mcrepeau/matrix_powerboard/powerboard/powerboard.png

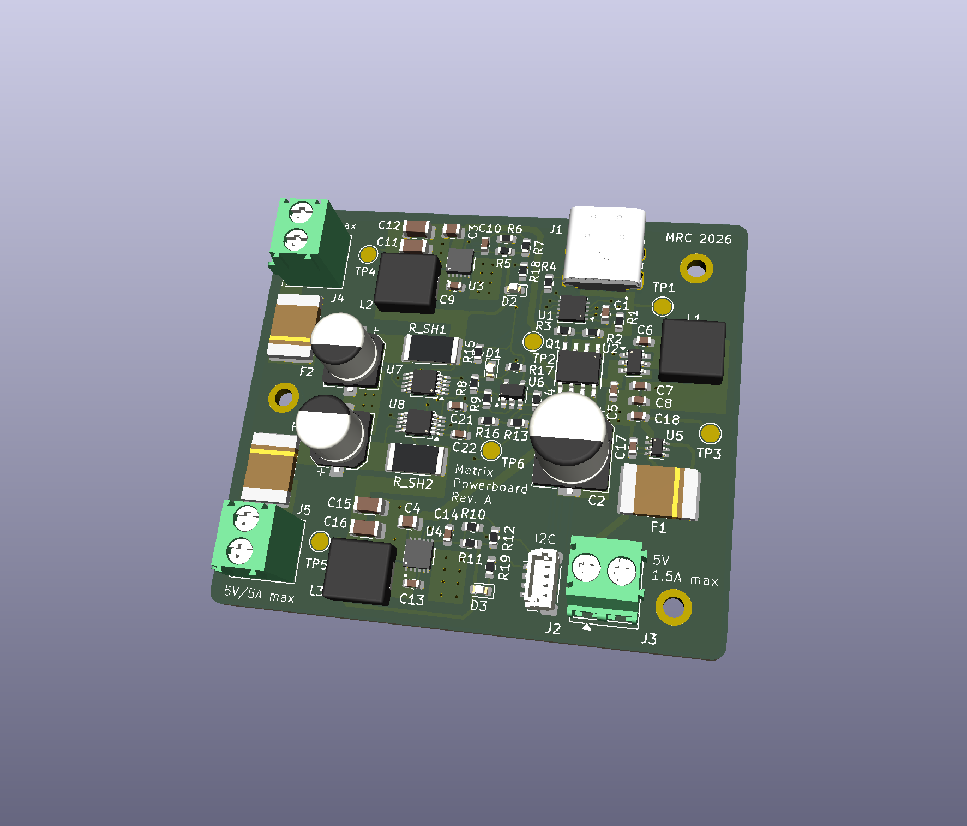
powerboard/powerboard.png
