mcrepeau/matrix_powerboard/hardware/powerboard.csv

Reference | Qty | Value | DNP | Footprint | Description | Part Number | LCSC Part #
C1,C17,C18 | 3 | 1µF/50V |  | Capacitor_SMD:C_0603_1608Metric | Unpolarized capacitor | CL10A105KB8NNNC | C15849
C2 | 1 | 100µF/35V |  | Capacitor_SMD:CP_Elec_8x10 | Polarized capacitor | GAM35V100M8X10 | C53446710
C3,C4,C5 | 3 | 10µF/50V |  | Capacitor_SMD:C_0805_2012Metric | Unpolarized capacitor | GRM21BR61H106KE43L | C440198
C6 | 1 | 100nF/50V |  | Capacitor_SMD:C_0603_1608Metric | Unpolarized capacitor | CC0603KRX7R9BB104 | C14663
C7,C8 | 2 | 22µF/25V |  | Capacitor_SMD:C_0805_2012Metric | Unpolarized capacitor | CL21A226MAQNNNE | C91604
C9,C13,C21,C22,C25 | 5 | 100nF |  | Capacitor_SMD:C_0603_1608Metric | Unpolarized capacitor | CC0603KRX7R9BB104 | C14663
C10,C14 | 2 | 33pF |  | Capacitor_SMD:C_0603_1608Metric | Unpolarized capacitor | CL10C330JB8NNNC | C1663
C11,C12,C15,C16 | 4 | 47µF/10V |  | Capacitor_SMD:C_1206_3216Metric | Unpolarized capacitor | CL31A476MPHNNNE | C96123
C19,C20 | 2 | 220µF/10V |  | Capacitor_SMD:CP_Elec_6.3x7.7 | Polarized capacitor | EEEFPA221XAP | C278407
D1 | 1 | RED LED |  | LED_SMD:LED_0805_2012Metric | Light emitting diode | NCD0805R1 | C84256
D2,D3 | 2 | GREEN LED |  | LED_SMD:LED_0805_2012Metric | Light emitting diode | KT-0805G | C2297
F1 | 1 | 1206L100/12NR |  | Fuse:Fuse_1206_3216Metric | Resettable fuse, polymeric positive temperature coefficient | 1206L100/12NR | C55089856
F2,F3 | 2 | 2920L700/12MR |  | Fuse:Fuse_2920_7451Metric | Resettable fuse, polymeric positive temperature coefficient | 2920L700/12MR | C207092
J1 | 1 | USB4085-GF-A |  | USB4085-GF-A_REVA4:GCT_USB4085-GF-A_REVA4 | USB-C (USB TYPE-C) USB 2.0 Receptacle Connector 24 (16+8 Dummy) Position Through Hole, Right Angle, low cost, 3.46mm profile, 16 pin, horizontal, Top mount | USB4085-GF-A | C7095263
J2 | 1 | SH1.0mm-4P-LT |  | Connector_JST:JST_SH_BM04B-SRSS-TB_1x04-1MP_P1.00mm_Vertical | Generic connector, single row, 01x04, script generated (kicad-library-utils/schlib/autogen/connector/) | BM04B-SRSS-TB | C160390
L1,L2,L3 | 3 | 4.7µH |  | Inductor_SMD:L_Bourns_SRP7028A_7.3x6.6mm | Inductor | APS0650M4R7A | C47327217
Q1 | 1 | AOSP21357 |  | AOSP21357:SO8SOP-8L_AOS-L |  | AOSP21357 | C541725
R1 | 1 | 10 |  | Resistor_SMD:R_0603_1608Metric | Resistor | 0603WAF100JT5E | C22859
R2 | 1 | 49.9K |  | Resistor_SMD:R_0603_1608Metric | Resistor | 0603WAF4992T5E | C23184
R3 | 1 | 5.1K |  | Resistor_SMD:R_0603_1608Metric | Resistor | 0603WAF5101T5E | C23186
R4 | 1 | 22.6k 1% |  | Resistor_SMD:R_0603_1608Metric | Resistor | CR0603FA2262G | C100874
R5,R11 | 2 | 100k 1% |  | Resistor_SMD:R_0603_1608Metric | Resistor | 0603WAF1003T5E | C25803
R6,R10 | 2 | 19.1k 1% |  | Resistor_SMD:R_0603_1608Metric | Resistor | CR0603FA1912G | C100835
R7,R12,R15 | 3 | 1k |  | Resistor_SMD:R_0603_1608Metric | Resistor | 0603WAF1001T5E | C21190
R8 | 1 | 100k |  | Resistor_SMD:R_0603_1608Metric | Resistor | 0603WAF1003T5E | C25803
R9 | 1 | 13k |  | Resistor_SMD:R_0603_1608Metric | Resistor | 0603WAF1302T5E | C22797
R13 | 1 | 510k |  | Resistor_SMD:R_0603_1608Metric | Resistor | 0603WAF5103T5E | C23192
R14 | 1 | 39k |  | Resistor_SMD:R_0603_1608Metric | Resistor | 0603WAF3902T5E | C23153
R16 | 1 | 2M |  | Resistor_SMD:R_0603_1608Metric | Resistor | 0603WAF2004T5E | C22976
R17 | 1 | 10k |  | Resistor_SMD:R_0603_1608Metric | Resistor | 0603WAF1002T5E | C25804
R18,R19 | 2 | 2.2k |  | Resistor_SMD:R_0603_1608Metric | Resistor | 0603WAF2201T5E | C4190
R_SH1,R_SH2 | 2 | 2mΩ 1% ≥1W |  | Resistor_SMD:R_2512_6332Metric | Resistor | RLP25FEER002 | C160590
U1 | 1 | HUSB238_002 |  | Package_DFN_QFN:WDFN-10-1EP_3x3mm_P0.5mm_EP1.8x2.5mm | USB-PD Sink IC Port Controller, VBUS = 3..25V, USB Type-C rev. 1.4, USB-PD rev. 3.0, BC1.2, WDFN-10 / WSON-10 | HUSB238_002DD | C7471904
U2 | 1 | AP63205 |  | Package_TO_SOT_SMD:TSOT-23-6 | 2A, 1.1MHz Buck DC/DC Converter, fixed 5.0V output voltage, TSOT-23-6 | AP63205WU-7 | C2071056
U3,U4 | 2 | LMR51450 |  | LMR51450:WSON_SDRRR_TEX |  | LMR51450SDRRR | C6890985
U5 | 1 | LM66100 |  | Package_TO_SOT_SMD:SOT-363_SC-70-6 | Ideal Diode With Input Polarity Protection 1.5 - 5.5V Input Voltage, 1.5A Output Current, Ron 141 mOhm, SC-70-6 | LM66100DCK | C2832141
U6 | 1 | LM397 |  | Package_TO_SOT_SMD:SOT-23-5 | Single General-Purpose Voltage Comparator with Open-Collector Output, SOT-23-5 | LM397MFX/NOPB | C132076
U7,U8 | 2 | INA226 |  | Package_SO:TSSOP-10_3x3mm_P0.5mm | High-Side or Low-Side Measurement, Bi-Directional Current and Power Monitor (0-36V) with I2C Compatible Interface, TSSOP-10 (Texas DGS0010A / VSSOP) | INA226AIDGSR | C49851
