mcrepeau/matrix_powerboard/hardware/powerboard.pdf

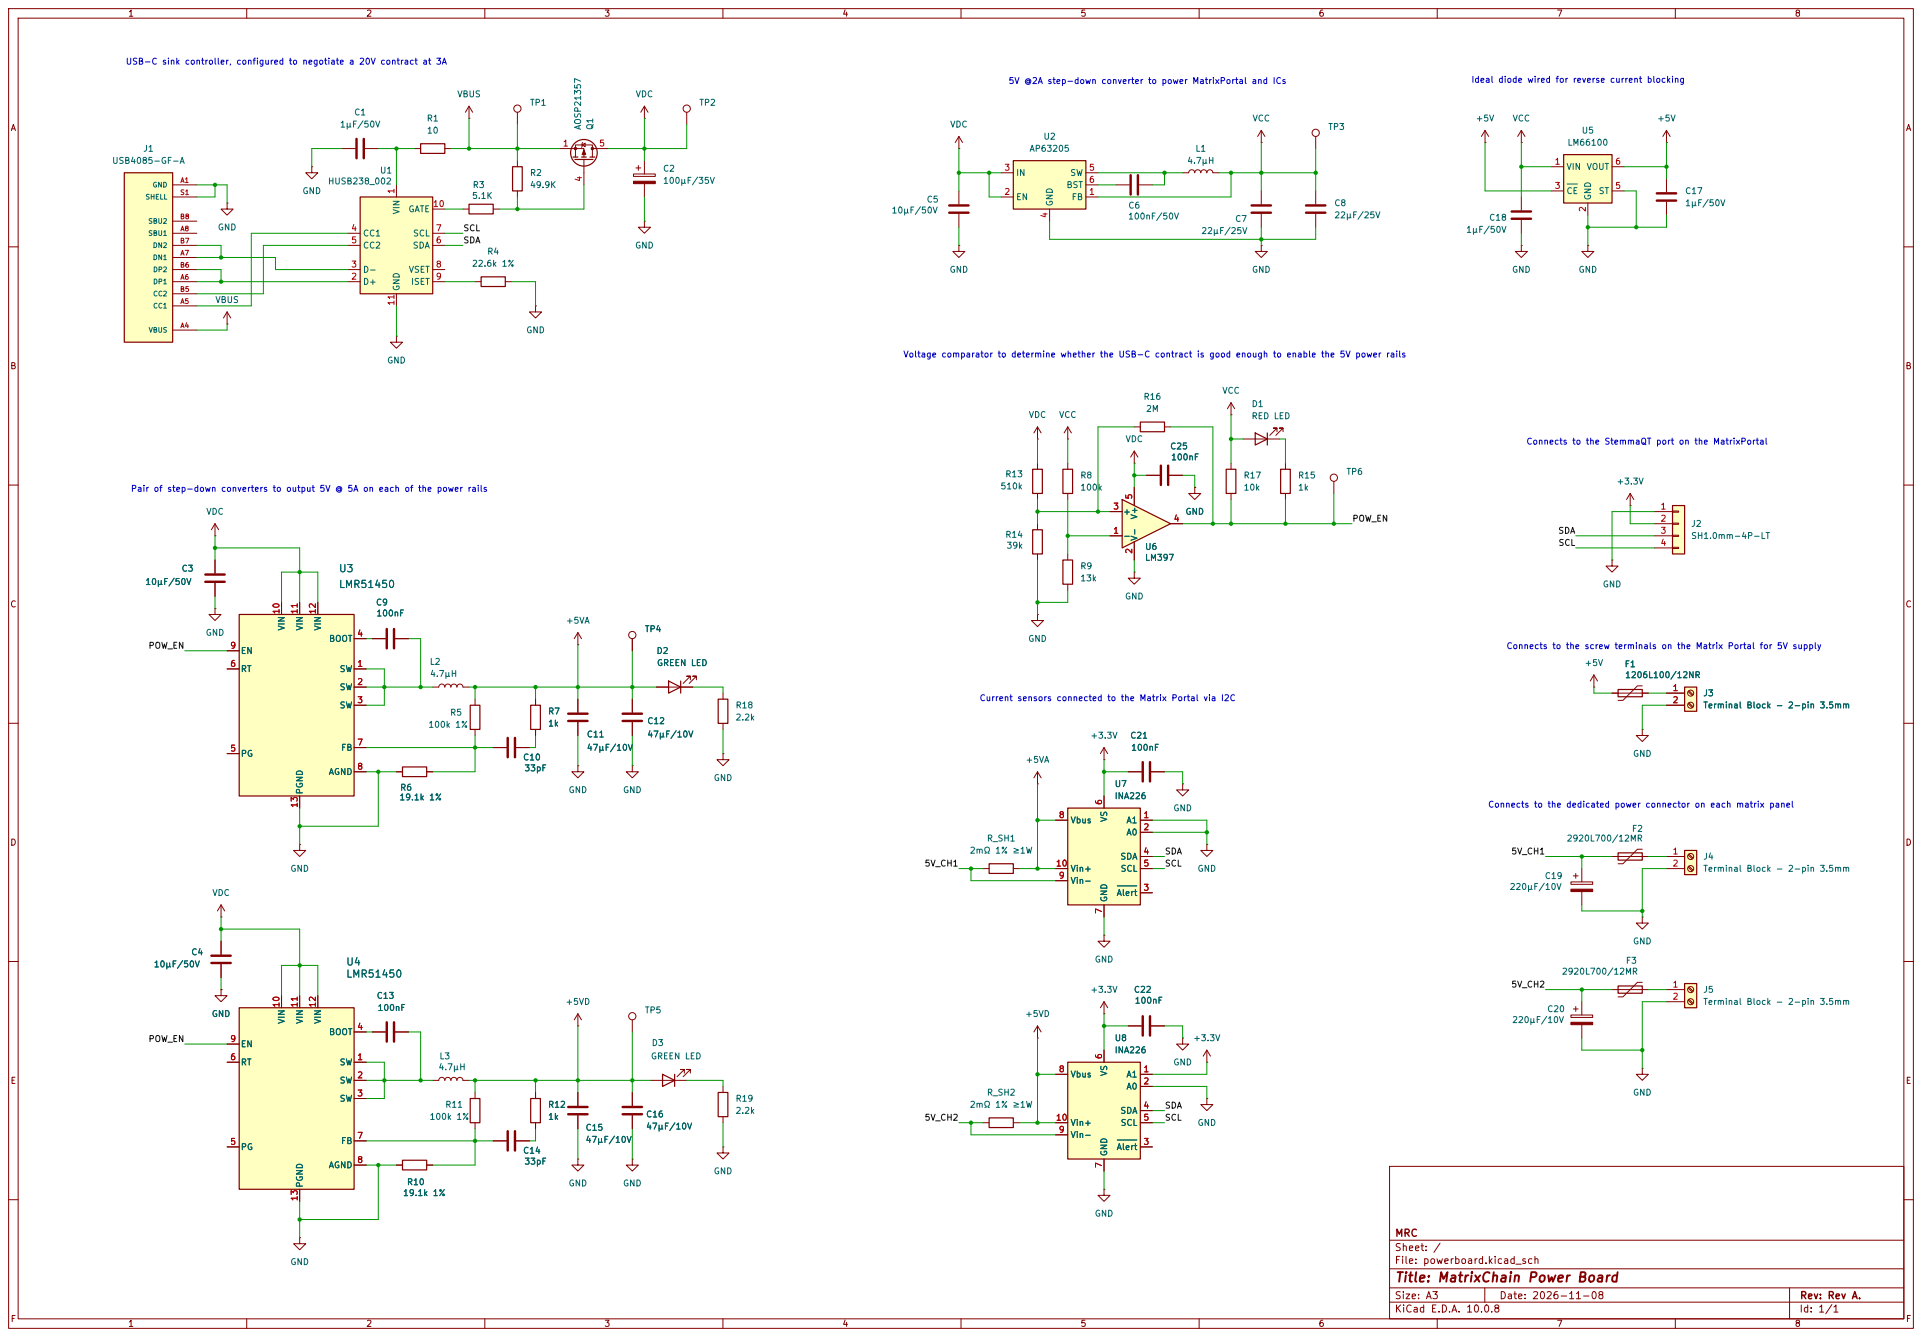
[picture p2: page 1]

Ideal diode wired for reverse current blocking

Connects to the dedicated power connector on each matrix panel Current sensors connected to the Matrix Portal via I2C

MRC
Sheet: /
File: powerboard.kicad_sch
Title: MatrixChain Power Board

Size: A3 | Rev: Rev A. | F Date: 2026-11-08
KiCad E.D.A. 10.0.8 | Id: 1/1
