mcrepeau/matrix_powerboard/hardware/powerboard.kicad_pcb

## KiCad design hardware/powerboard.kicad_pcb (2026-11-14)

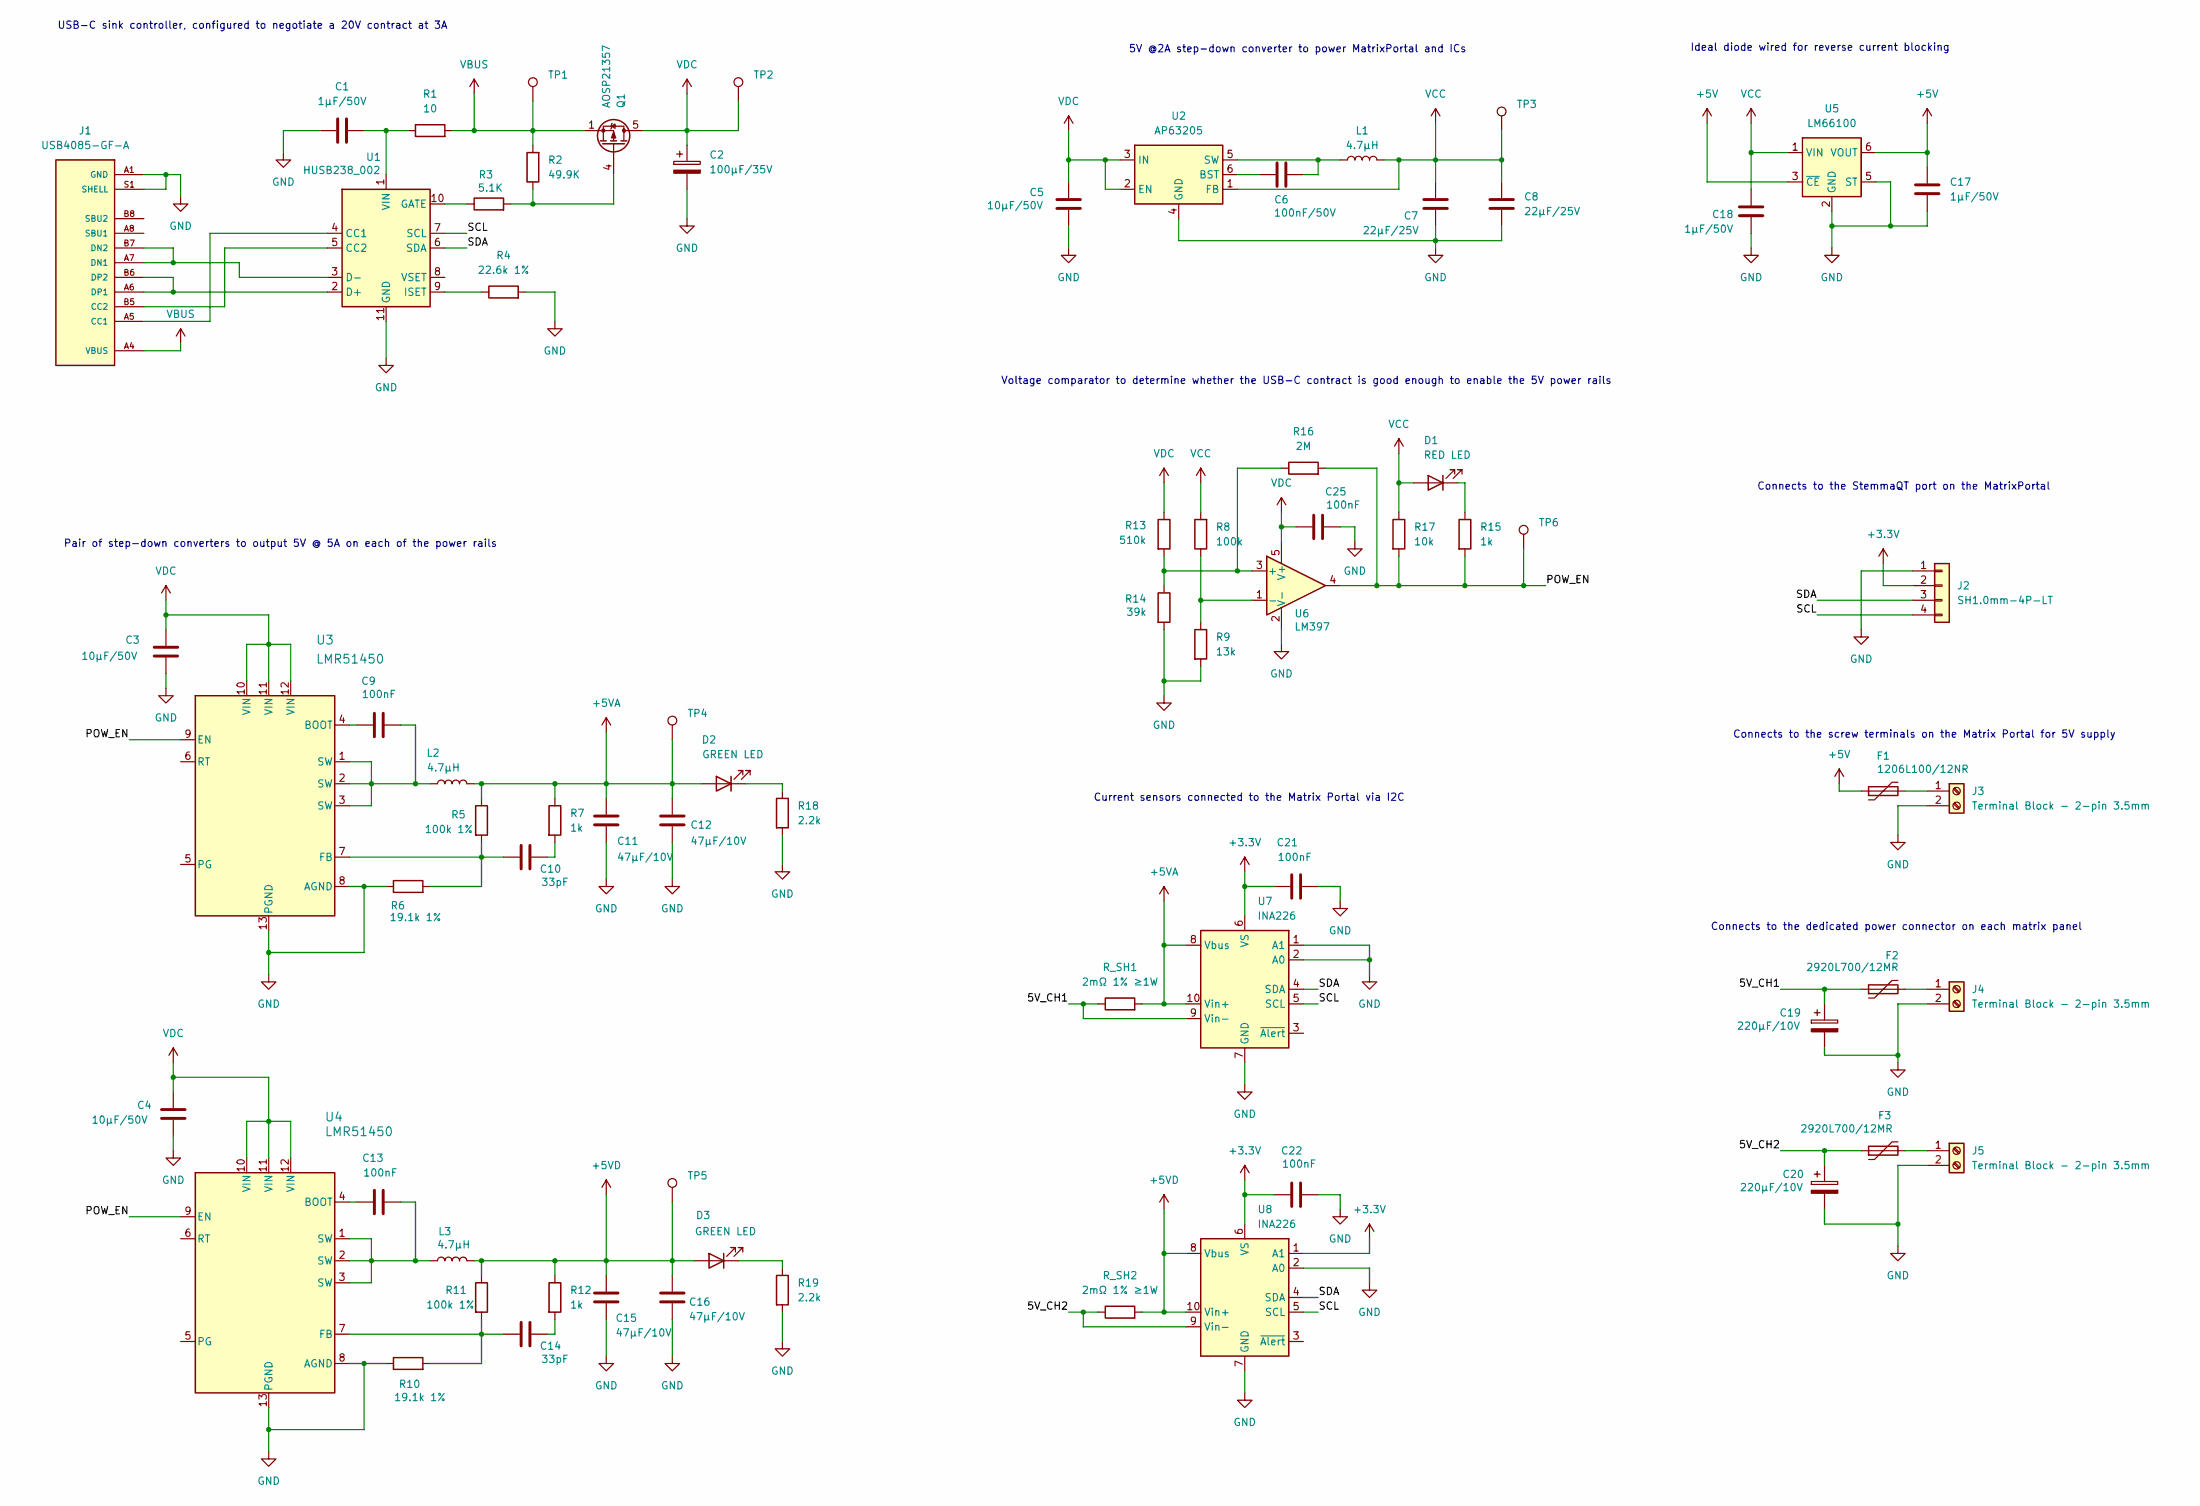
[picture p3: schematic powerboard.kicad_sch, MatrixChain Power Board]

Parts:
C1, C17, C18: 1µF/50V; C_0603_1608Metric; Part Number CL10A105KB8NNNC; LCSC Part # C15849
C2: 100µF/35V; CP_Elec_8x10; Part Number GAM35V100M8X10; LCSC Part # C53446710
C3, C4, C5: 10µF/50V; C_0805_2012Metric; Part Number GRM21BR61H106KE43L; LCSC Part # C440198
C6: 100nF/50V; C_0603_1608Metric; Part Number CC0603KRX7R9BB104; LCSC Part # C14663
C7, C8: 22µF/25V; C_0805_2012Metric; Part Number CL21A226MAQNNNE; LCSC Part # C91604
C9, C13, C21, C22, C25: 100nF; C_0603_1608Metric; Part Number CC0603KRX7R9BB104; LCSC Part # C14663
C10, C14: 33pF; C_0603_1608Metric; Part Number CL10C330JB8NNNC; LCSC Part # C1663
C11, C12, C15, C16: 47µF/10V; C_1206_3216Metric; Part Number CL31A476MPHNNNE; LCSC Part # C96123
C19, C20: 220µF/10V; CP_Elec_6.3x7.7; Part Number EEEFPA221XAP; LCSC Part # C278407
D1: RED LED; LED_0805_2012Metric; Part Number NCD0805R1; LCSC Part # C84256
D2, D3: GREEN LED; LED_0805_2012Metric; Part Number KT-0805G; LCSC Part # C2297
F1: 1206L100/12NR; Fuse_1206_3216Metric; Part Number 1206L100/12NR; LCSC Part # C55089856
F2, F3: 2920L700/12MR; Fuse_2920_7451Metric; Part Number 2920L700/12MR; LCSC Part # C207092
J1: USB4085-GF-A; GCT_USB4085-GF-A_REVA4; MPN USB4085-GF-A; LCSC Part # C7095263
J2: SH1.0mm-4P-LT; JST_SH_BM04B-SRSS-TB_1x04-1MP_P1.00mm_Vertical; Part Number BM04B-SRSS-TB; LCSC Part # C160390
J3, J4, J5: Terminal Block - 2-pin 3.5mm; TerminalBlock_Phoenix_PT-1,5-2-3.5-H_1x02_P3.50mm_Horizontal
L1, L2, L3: 4.7µH; L_Bourns_SRP7028A_7.3x6.6mm; Part Number APS0650M4R7A; LCSC Part # C47327217
Q1: AOSP21357; SO8SOP-8L_AOS-L; Part Number AOSP21357; LCSC Part # C541725
R1: 10; R_0603_1608Metric; Part Number 0603WAF100JT5E; LCSC Part # C22859
R2: 49.9K; R_0603_1608Metric; Part Number 0603WAF4992T5E; LCSC Part # C23184
R3: 5.1K; R_0603_1608Metric; Part Number 0603WAF5101T5E; LCSC Part # C23186
R4: 22.6k 1%; R_0603_1608Metric; Part Number CR0603FA2262G; LCSC Part # C100874
R5, R11: 100k 1%; R_0603_1608Metric; Part Number 0603WAF1003T5E; LCSC Part # C25803
R6, R10: 19.1k 1%; R_0603_1608Metric; Part Number CR0603FA1912G; LCSC Part # C100835
R7, R12, R15: 1k; R_0603_1608Metric; Part Number 0603WAF1001T5E; LCSC Part # C21190
R8: 100k; R_0603_1608Metric; Part Number 0603WAF1003T5E; LCSC Part # C25803
R9: 13k; R_0603_1608Metric; Part Number 0603WAF1302T5E; LCSC Part # C22797
R13: 510k; R_0603_1608Metric; Part Number 0603WAF5103T5E; LCSC Part # C23192
R14: 39k; R_0603_1608Metric; Part Number 0603WAF3902T5E; LCSC Part # C23153
R16: 2M; R_0603_1608Metric; Part Number 0603WAF2004T5E; LCSC Part # C22976
R17: 10k; R_0603_1608Metric; Part Number 0603WAF1002T5E; LCSC Part # C25804
R18, R19: 2.2k; R_0603_1608Metric; Part Number 0603WAF2201T5E; LCSC Part # C4190
R_SH1, R_SH2: 2mΩ 1% ≥1W; R_2512_6332Metric; Part Number RLP25FEER002; LCSC Part # C160590
TP1, TP2, TP3, TP4, TP5, TP6: TestPoint; TestPoint_Pad_D2.0mm
U1: HUSB238_002; WDFN-10-1EP_3x3mm_P0.5mm_EP1.8x2.5mm; Part Number HUSB238_002DD; LCSC Part # C7471904
U2: AP63205; TSOT-23-6; Part Number AP63205WU-7; LCSC Part # C2071056
U3, U4: LMR51450; WSON_SDRRR_TEX; Part Number LMR51450SDRRR; LCSC Part # C6890985
U5: LM66100; SOT-363_SC-70-6; Part Number LM66100DCK; LCSC Part # C2832141
U6: LM397; SOT-23-5; Part Number LM397MFX/NOPB; LCSC Part # C132076
U7, U8: INA226; TSSOP-10_3x3mm_P0.5mm; Part Number INA226AIDGSR; LCSC Part # C49851

Connections:
+3.3V: C21.1, C22.1, J2.2, U7.6 (VS), U8.1 (A1), U8.6 (VS)
+5V: C17.1, F1.1, U5.3 (~CE), U5.6 (VOUT)
+5VA: C11.1, C12.1, D2.2 (A), L2.2, R5.1, R7.1, R_SH1.2, TP4.1 (1_1), U7.8 (Vbus), U7.10 (Vin+)
+5VD: C15.1, C16.1, D3.2 (A), L3.2, R11.1, R12.1, R_SH2.2, TP5.1 (1_1), U8.8 (Vbus), U8.10 (Vin+)
/5V_CH1: C19.1, F2.1, R_SH1.1, U7.9 (Vin-)
/5V_CH2: C20.1, F3.1, R_SH2.1, U8.9 (Vin-)
/POW_EN: R15.2, R16.2, R17.2, TP6.1 (1_1), U3.9 (EN), U4.9 (EN), U6.4
/SCL: J2.4, U1.7 (SCL), U7.5 (SCL), U8.5 (SCL)
/SDA: J2.3, U1.6 (SDA), U7.4 (SDA), U8.4 (SDA)
GND: C1.1, C2.2, C3.2, C4.2, C5.2, C7.2, C8.2, C11.2, C12.2, C15.2, C16.2, C17.2, C18.2, C19.2, C20.2, C21.2, C22.2, C25.2, J1.A1 (GND), J1.A12 (GND), J1.B1 (GND), J1.B12 (GND), J1.S1 (SHELL), J1.S2 (SHELL), J1.S3 (SHELL), J1.S4 (SHELL), J2.1, J3.2, J4.2, J5.2, R4.2, R6.1, R9.2, R10.1, R14.2, R18.2, R19.2, U1.11 (GND), U2.4 (GND), U3.8 (AGND), U3.13 (PGND), U4.8 (AGND), U4.13 (PGND), U5.2 (GND), U5.5 (ST), U6.2 (V-), U7.1 (A1), U7.2 (A0), U7.7 (GND), U8.2 (A0), U8.7 (GND)
unnamed: C9.2, L2.1, U3.1 (SW), U3.2 (SW), U3.3 (SW)
unnamed: C10.2, R7.2
unnamed: C13.2, L3.1, U4.1 (SW), U4.2 (SW), U4.3 (SW)
unnamed: C14.2, R12.2
unnamed: D1.1 (K), R15.1
unnamed: D2.1 (K), R18.1
unnamed: D3.1 (K), R19.1
unnamed: J1.A5 (CC1), U1.4 (CC1)
unnamed: J1.B5 (CC2), U1.5 (CC2)
unnamed: J1.A7 (DN1), J1.B7 (DN2), U1.3 (D-)
unnamed: J1.A6 (DP1), J1.B6 (DP2), U1.2 (D+)
unnamed: F1.2, J3.1
unnamed: F2.2, J4.1
unnamed: F3.2, J5.1
unnamed: Q1.4 (G), R2.1, R3.2
unnamed: R3.1, U1.10 (GATE)
unnamed: R4.1, U1.9 (ISET)
unnamed: C1.2, R1.1, U1.1 (VIN)
unnamed: C6.1, U2.6 (BST)
unnamed: C6.2, L1.1, U2.5 (SW)
unnamed: C9.1, U3.4 (BOOT)
unnamed: C10.1, R5.2, R6.2, U3.7 (FB)
unnamed: C13.1, U4.4 (BOOT)
unnamed: C14.1, R10.2, R11.2, U4.7 (FB)
unnamed: R13.2, R14.1, R16.1, U6.3 (+)
unnamed: R8.1, R9.1, U6.1 (-)
VBUS: J1.A4 (VBUS), J1.A9 (VBUS), J1.B4 (VBUS), J1.B9 (VBUS), Q1.1 (S), Q1.2 (S), Q1.3 (S), R1.2, R2.2, TP1.1 (1_1)
VCC: C7.1, C8.1, C18.1, D1.2 (A), L1.2, R8.2, R17.1, TP3.1 (1_1), U2.1 (FB), U5.1 (VIN)
VDC: C2.1, C3.1, C4.1, C5.1, C25.1, Q1.5 (D), Q1.6 (D), Q1.7 (D), Q1.8 (D), R13.1, TP2.1 (1_1), U2.2 (EN), U2.3 (IN), U3.10 (VIN), U3.11 (VIN), U3.12 (VIN), U4.10 (VIN), U4.11 (VIN), U4.12 (VIN), U6.5 (V+)

Notes on the sheet:
Connects to the screw terminals on the Matrix Portal for 5V supply
Connects to the dedicated power connector on each matrix panel
Connects to the StemmaQT port on the MatrixPortal
Pair of step-down converters to output 5V @ 5A on each of the power rails
Voltage comparator to determine whether the USB-C contract is good enough to enable the 5V power rails
Current sensors connected to the Matrix Portal via I2C
5V @2A step-down converter to power MatrixPortal and ICs
USB-C sink controller, configured to negotiate a 20V contract at 3A
Ideal diode wired for reverse current blocking

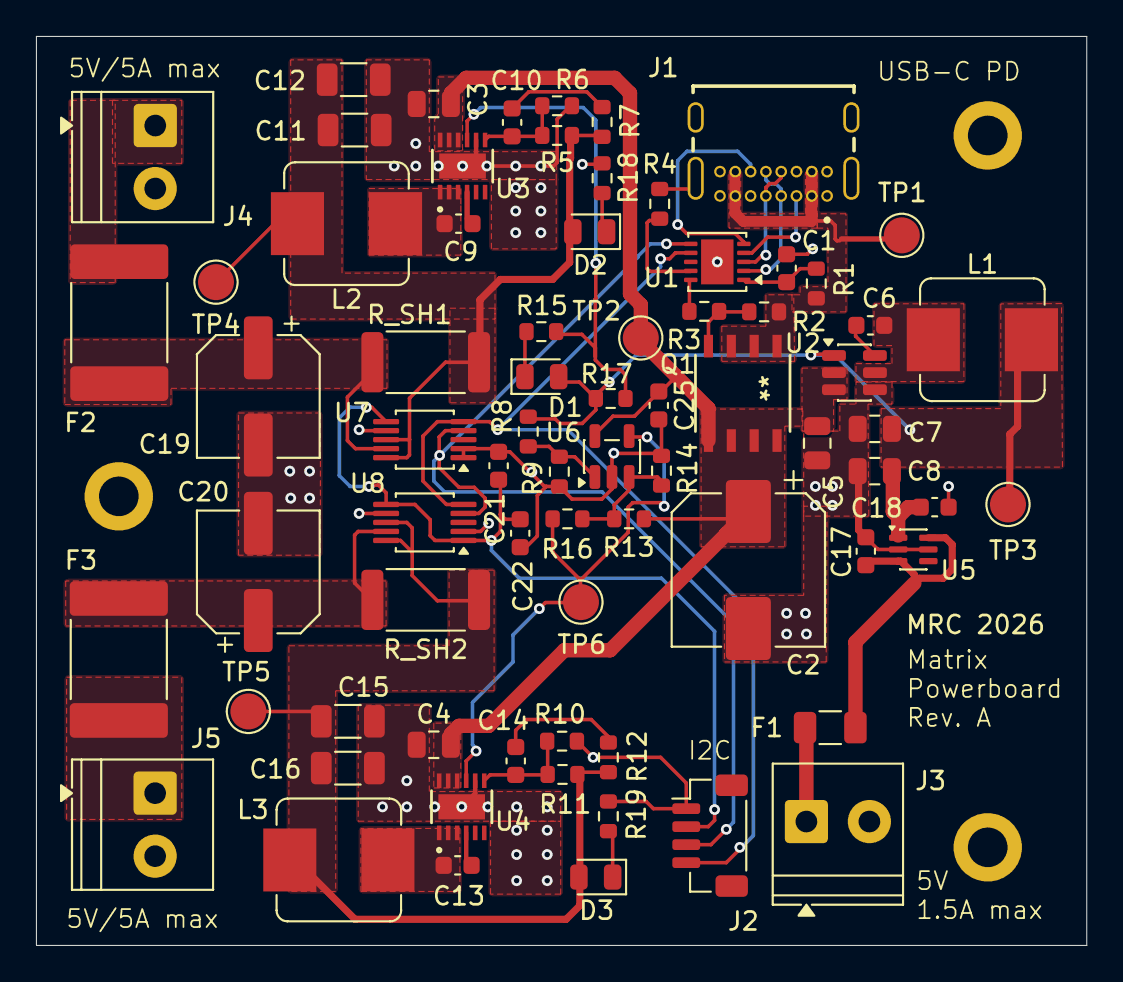
[picture p4: board powerboard.kicad_pcb from above]

Board: 2 copper layers, 58.3 x 50.5 mm, 75 parts (0 on the bottom side), 39 nets.

Other parts of the board:
MRC 2026: MountingHole_2.2mm_M2_DIN965_Pad
Matrix PowerBoard Rev. A: MountingHole_2.2mm_M2_DIN965_Pad
