mcrepeau/matrix_powerboard/(commit log)

2026-11-11 Widened traces
2026-11-11 Finishing touches to PCB layout
2026-11-12 Minute adjustments to PCB layout
2026-11-12 Added all parts numbers for LEDs and caps
2026-11-12 Added part numbers for all ICs and fuses
2026-11-12 Added BOM
2026-11-12 Hide LCSC Part Number from schematic
2026-11-13 Added schematic PDF
2026-11-13 Added missing footprints
2026-11-13 Reworked layout with new footprints
